mayank5885/Lab-Scale-Flume-Setup-for-Soil-Flow-Study/README.md

# Lab Scale Flume Setup for Soil Flow Study

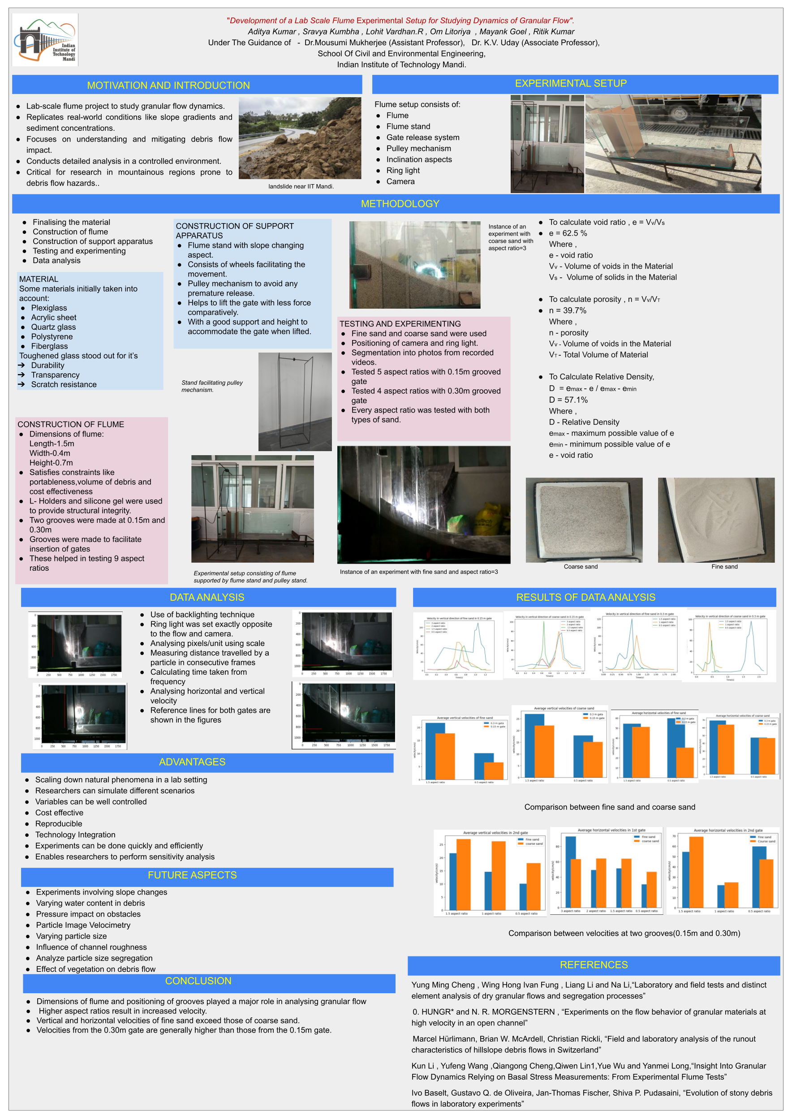
[picture p1: POSTER.png]
POSTER_final
