mayank5885/Lab-Scale-Flume-Setup-for-Soil-Flow-Study/POSTER_final.pdf

"Development of a Lab Scale Flume Experimental Setup for Studying Dynamics of Granular Flow". Aditya Kumar , Sravya Kumbha , Lohit Vardhan.R , Om Litoriya , Mayank Goel , Ritik Kumar Under The Guidance of - Dr.Mousumi Mukherjee (Assistant Professor), Dr. K.V. Uday (Associate Professor), School Of Civil and Environmental Engineering, Indian Institute of Technology Mandi.

### MOTIVATION AND INTRODUCTION

### METHODOLOGY

### RESULTS OF DATA ANALYSIS

### FUTURE ASPECTS

### ADVANTAGES

### CONCLUSION

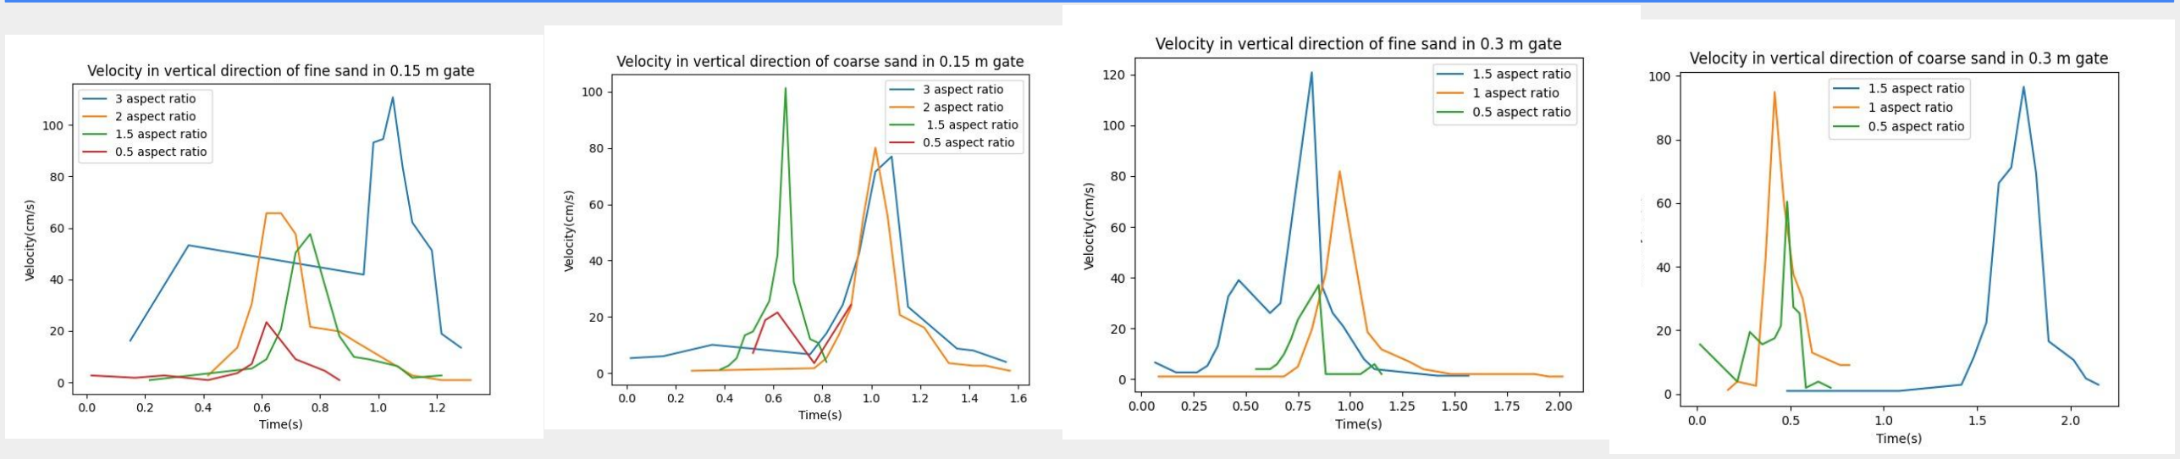
[picture p22: figure]

### REFERENCES

- Lab-scale flume project to study granular flow dynamics.
- Replicates real-world conditions like slope gradients and sediment concentrations.
- Focuses on understanding and mitigating debris flow impact.
- Conducts detailed analysis in a controlled environment.
- Critical for research in mountainous regions prone to debris flow hazards..
- Scaling down natural phenomena in a lab setting
- Researchers can simulate different scenarios
- Variables can be well controlled
- Cost effective
- Reproducible
- Technology Integration
- Experiments can be done quickly and efficiently
- Enables researchers to perform sensitivity analysis
- Experiments involving slope changes
- Varying water content in debris
- Pressure impact on obstacles
- Particle Image Velocimetry
- Varying particle size
- Influence of channel roughness
- Analyze particle size segregation
- Effect of vegetation on debris flow
- To calculate void ratio , e = Vv/Vs
- e = 62.5 %
Where ,
e - void ratio
Vv - Volume of voids in the Material Vs - Volume of solids in the Material
- To calculate porosity , n = Vv/VT
- n = 39.7%
Where ,
n - porosity
Vv - Volume of voids in the Material VT - Total Volume of Material
- To Calculate Relative Density,

D = emax - e / emax - emin
D = 57.1%
Where ,
D - Relative Density
emax - maximum possible value of e emin - minimum possible value of e e - void ratio

Yung Ming Cheng , Wing Hong Ivan Fung , Liang Li and Na Li,“Laboratory and field tests and distinct element analysis of dry granular flows and segregation processes”

0. HUNGR* and N. R. MORGENSTERN , “Experiments on the flow behavior of granular materials at high velocity in an open channel”

Marcel Hürlimann, Brian W. McArdell, Christian Rickli, “Field and laboratory analysis of the runout characteristics of hillslope debris flows in Switzerland”

Kun Li , Yufeng Wang ,Qiangong Cheng,Qiwen Lin1,Yue Wu and Yanmei Long,“Insight Into Granular Flow Dynamics Relying on Basal Stress Measurements: From Experimental Flume Tests”

Ivo Baselt, Gustavo Q. de Oliveira, Jan-Thomas Fischer, Shiva P. Pudasaini, “Evolution of stony debris flows in laboratory experiments”

- Finalising the material
- Construction of flume
- Construction of support apparatus
- Testing and experimenting
- Data analysis

CONSTRUCTION OF FLUME
- Dimensions of flume:
Length-1.5m
Width-0.4m
Height-0.7m
- Satisfies constraints like portableness,volume of debris and cost effectiveness
- L- Holders and silicone gel were used to provide structural integrity.
- Two grooves were made at 0.15m and 0.30m
- Grooves were made to facilitate insertion of gates
- These helped in testing 9 aspect ratios

Flume setup consists of:
- Flume
- Flume stand
- Gate release system
- Pulley mechanism
- Inclination aspects
- Ring light
- Camera

MATERIAL
Some materials initially taken into account:
- Plexiglass
- Acrylic sheet
- Quartz glass
- Polystyrene
- Fiberglass
Toughened glass stood out for it’s ➔ Durability
➔ Transparency
➔ Scratch resistance

### EXPERIMENTAL SETUP

CONSTRUCTION OF SUPPORT
APPARATUS
- Flume stand with slope changing aspect.
- Consists of wheels facilitating the movement.
- Pulley mechanism to avoid any premature release.
- Helps to lift the gate with less force comparatively.
- With a good support and height to accommodate the gate when lifted.

TESTING AND EXPERIMENTING
- Fine sand and coarse sand were used
- Positioning of camera and ring light.
- Segmentation into photos from recorded videos.
- Tested 5 aspect ratios with 0.15m grooved gate
- Tested 4 aspect ratios with 0.30m grooved gate
- Every aspect ratio was tested with both types of sand.

Stand facilitating pulley
mechanism.

Experimental setup consisting of flume supported by flume stand and pulley stand.

### DATA ANALYSIS

- Use of backlighting technique
- Ring light was set exactly opposite to the flow and camera.
- Analysing pixels/unit using scale
- Measuring distance travelled by a particle in consecutive frames
- Calculating time taken from frequency
- Analysing horizontal and vertical velocity
- Reference lines for both gates are shown in the figures
Coarse sand | Fine sand

landslide near IIT Mandi.

Instance of an experiment with fine sand and aspect ratio=3

Instance of an
experiment with
coarse sand with
aspect ratio=3

Comparison between fine sand and coarse sand

Comparison between velocities at two grooves(0.15m and 0.30m)

- Dimensions of flume and positioning of grooves played a major role in analysing granular flow
- Higher aspect ratios result in increased velocity.
- Vertical and horizontal velocities of fine sand exceed those of coarse sand.
- Velocities from the 0.30m gate are generally higher than those from the 0.15m gate.
