mayank5885/Lab-Scale-Flume-Setup-for-Soil-Flow-Study/cad files /dimet.JPG

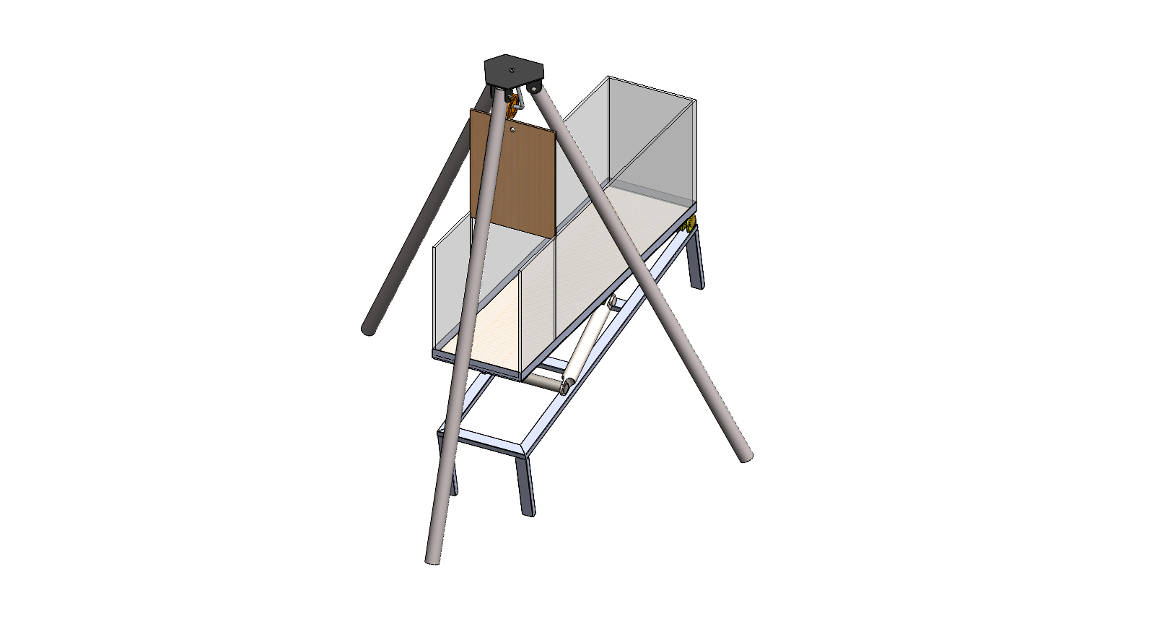
cad files /dimet.JPG
