mayank5885/Lab-Scale-Flume-Setup-for-Soil-Flow-Study/cad files /front.JPG

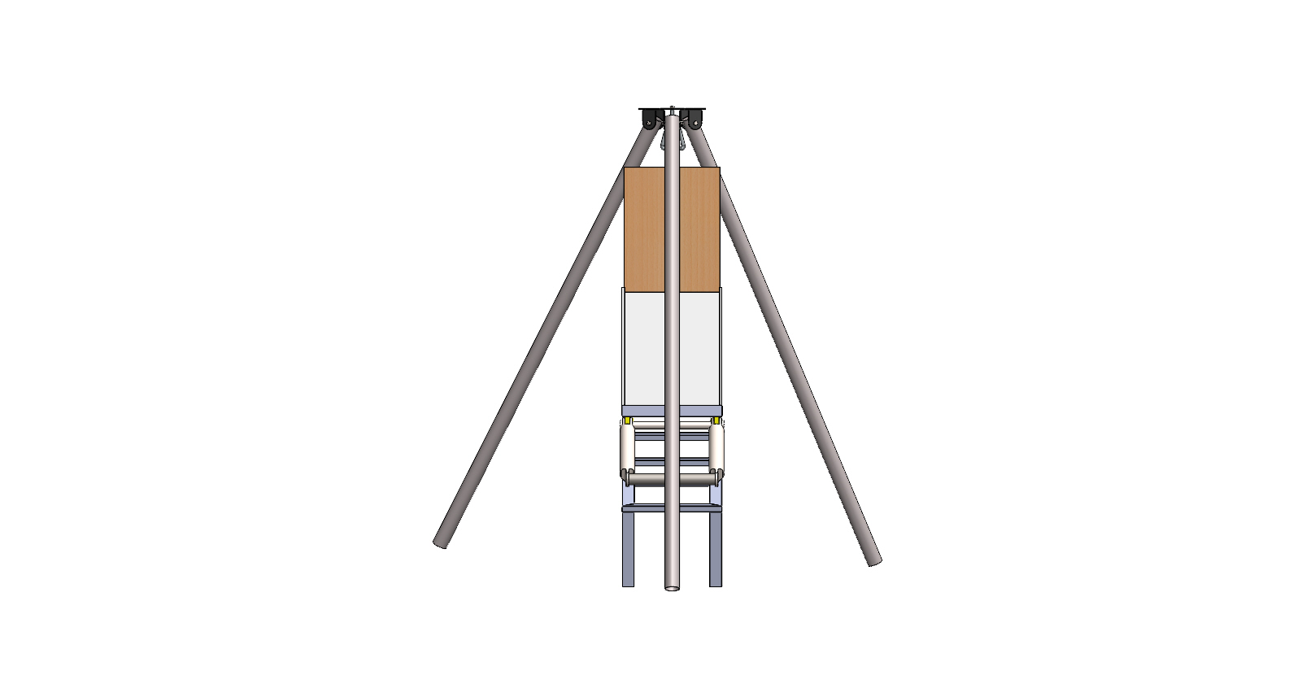
cad files /front.JPG
