mayank5885/Lab-Scale-Flume-Setup-for-Soil-Flow-Study/cad files /isometric.JPG

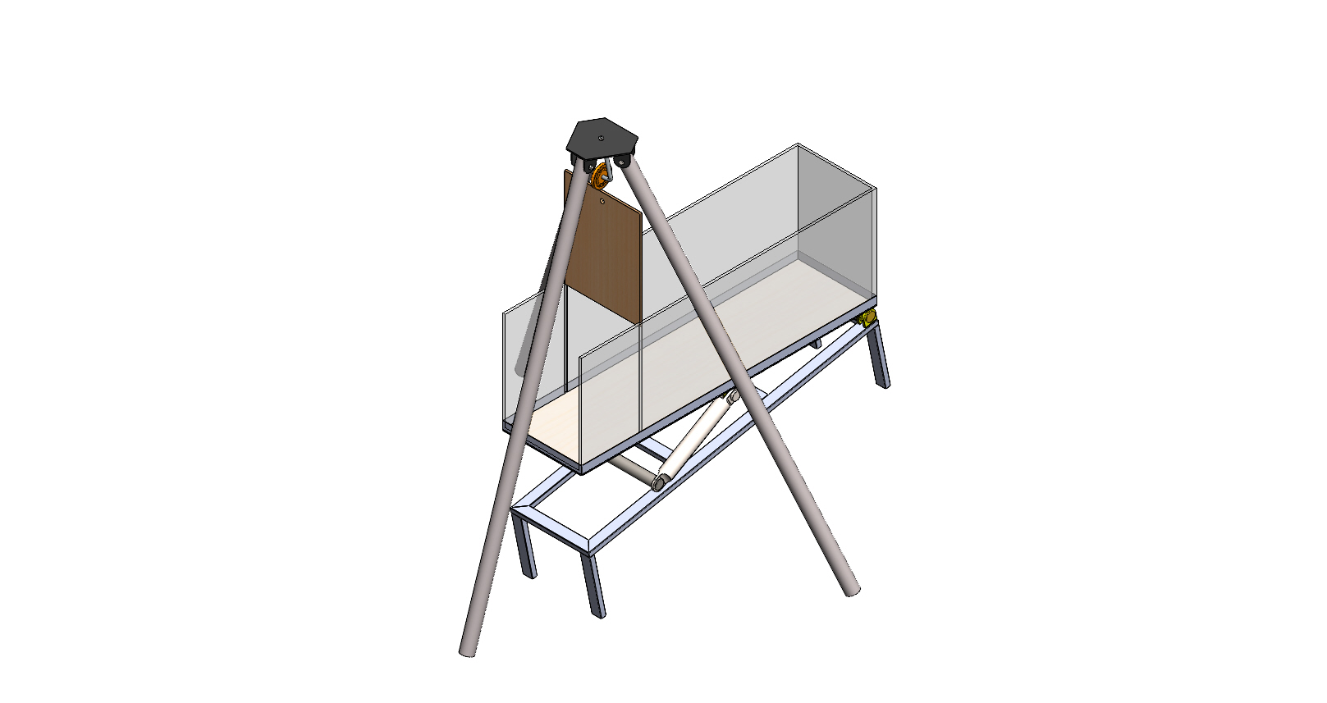
cad files /isometric.JPG
