mayank5885/Lab-Scale-Flume-Setup-for-Soil-Flow-Study/cad files /right.JPG

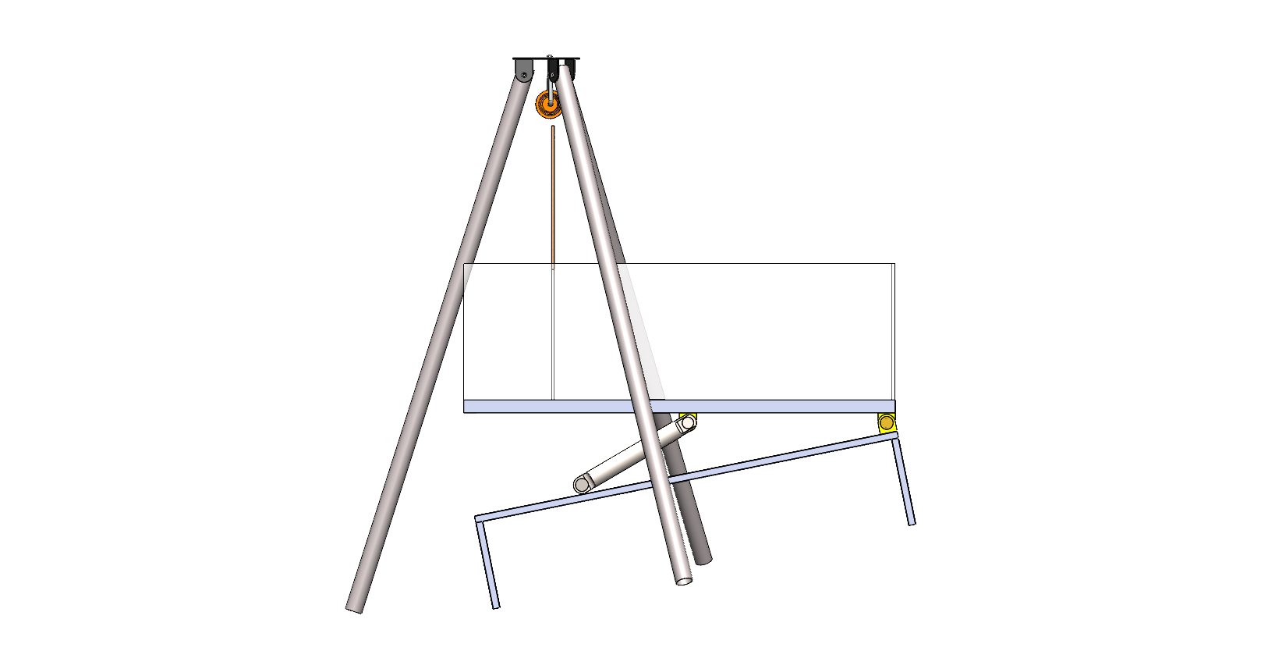
cad files /right.JPG
