mayank5885/Lab-Scale-Flume-Setup-for-Soil-Flow-Study/graph1.png

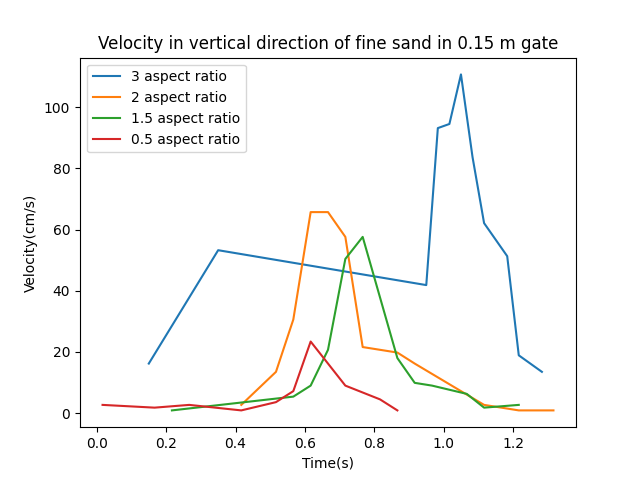
graph1.png
