mayank5885/Lab-Scale-Flume-Setup-for-Soil-Flow-Study/cad files /back.SLDASM

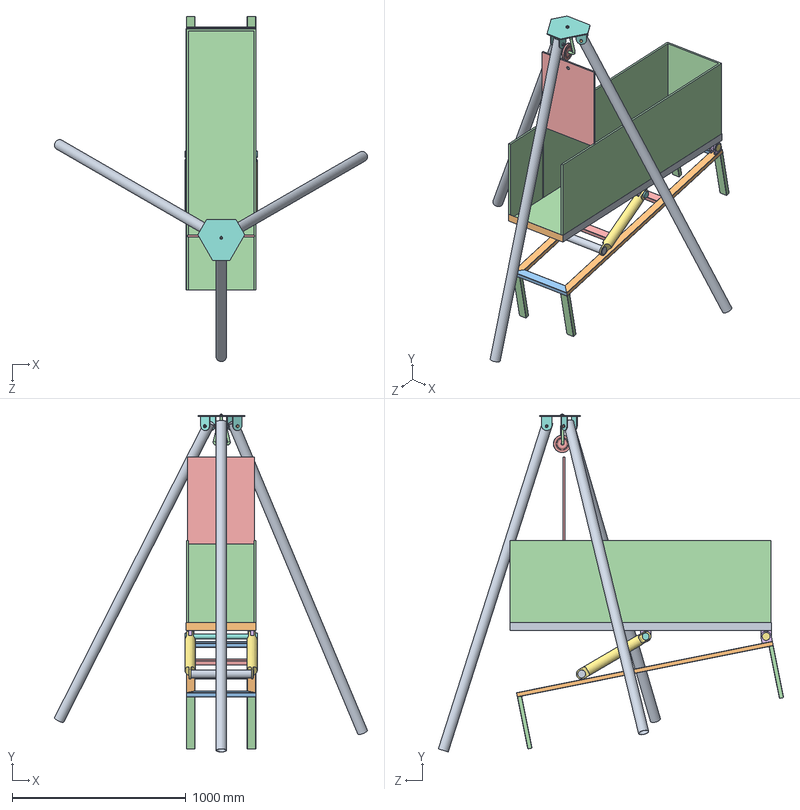
[picture p28: CAD file, 2024-07-07]
cad files /back.SLDASM
1799.6 x 1942.7 x 1985.0 mm
lbrack1500 x 2
lbrack400 x 2
baswood
glass
gate
hin x 4
supp x 2
uprod
dowsupp
recpro1500 x 2
recpro400 x 2
recpro1ft x 4
recpro100mm x 2
hing10 x 4
scre x 2
top
pipe x 3
hhs(grade c)_is x 3
hexagon nut style 1_is x 4
pullley holder
pulley
