mayank5885/Lab-Scale-Flume-Setup-for-Soil-Flow-Study/cad files /Flume Stand/pulley 3/Assem3.SLDASM

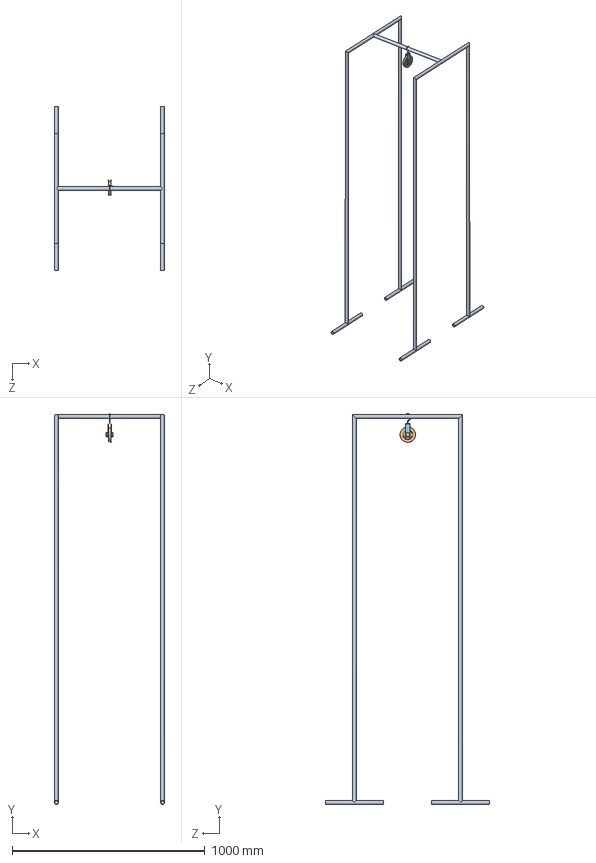
[picture p29: CAD file, 2024-07-07]
cad files /Flume Stand/pulley 3/Assem3.SLDASM
572.1 x 2026.0 x 850.8 mm
stand
pulley
holder
hex finished bolt_ai
heavy hex nut_ai
