mayank5885/Lab-Scale-Flume-Setup-for-Soil-Flow-Study/cad files /Flume Stand/flume Stand-Ritik.SLDASM

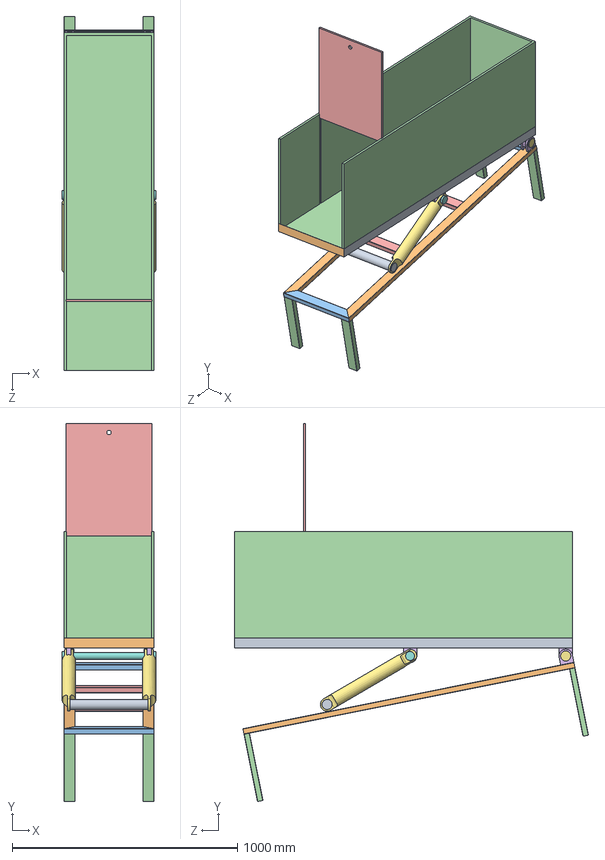
[picture p30: CAD file, 2024-07-07]
cad files /Flume Stand/flume Stand-Ritik.SLDASM
416.7 x 1679.5 x 1572.8 mm
lbrack1500 x 2
lbrack400 x 2
baswood
glass
gate
hin x 4
supp x 2
uprod
dowsupp
recpro1500 x 2
recpro400 x 2
recpro1ft x 4
recpro100mm x 2
hing10 x 4
scre x 2
