mayank5885/Lab-Scale-Flume-Setup-for-Soil-Flow-Study/cad files /Flume 2.SLDASM

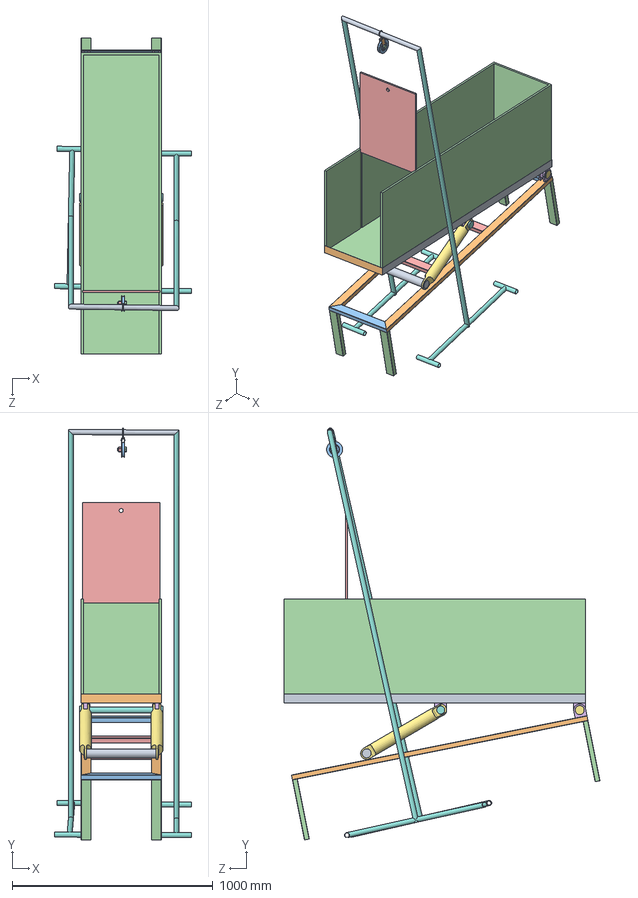
[picture p31: CAD file, 2024-07-07]
cad files /Flume 2.SLDASM
682.2 x 2050.1 x 1572.8 mm
lbrack1500 x 2
lbrack400 x 2
baswood
glass
gate
hin x 4
supp x 2
uprod
dowsupp
recpro1500 x 2
recpro400 x 2
recpro1ft x 4
recpro100mm x 2
hing10 x 4
scre x 2
std x 2
top
holder
pulley
hexagon fit bolt_is
heavy hex nut_ai
