mayank5885/Lab-Scale-Flume-Setup-for-Soil-Flow-Study/cad files /Flume Stand/pulley/Pulley Setup.SLDASM

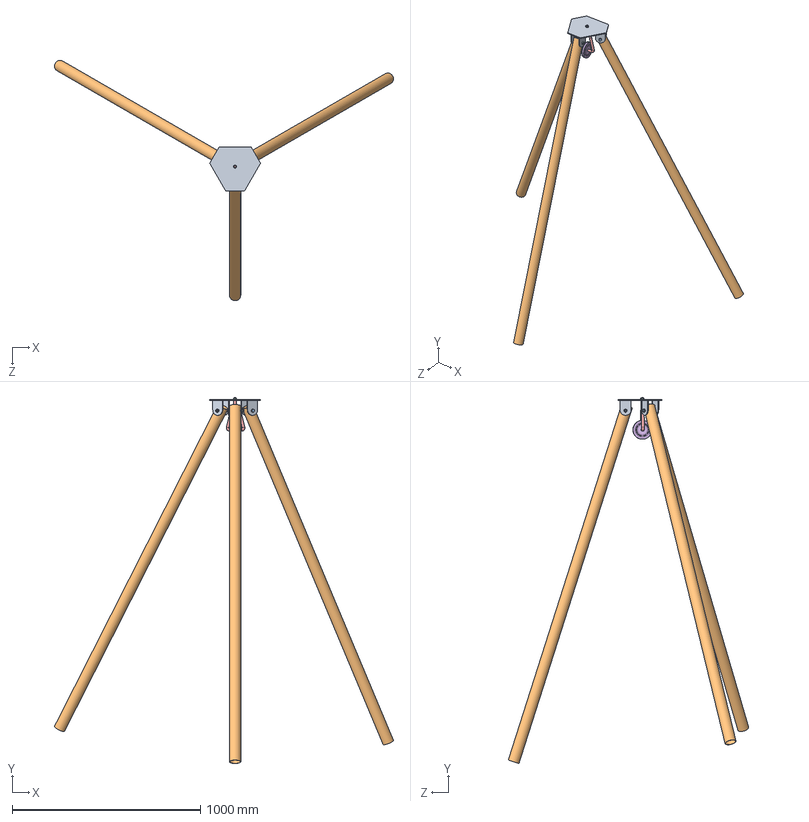
[picture p32: CAD file, 2024-07-07]
cad files /Flume Stand/pulley/Pulley Setup.SLDASM
1799.6 x 1942.7 x 1276.6 mm
top
pipe x 3
hhs(grade c)_is x 3
hexagon nut style 1_is x 4
pullley holder
pulley
