mayank5885/Lab-Scale-Flume-Setup-for-Soil-Flow-Study/cad files /Flume 3.SLDASM

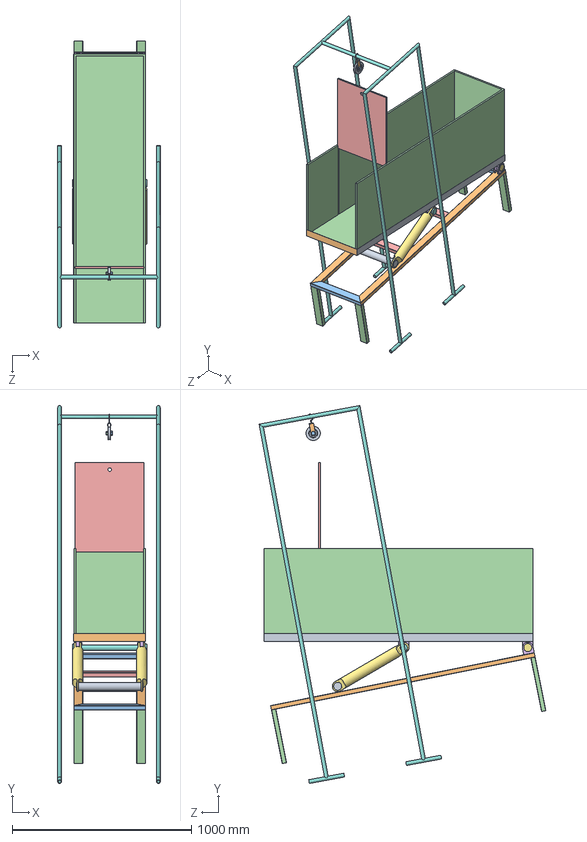
[picture p33: CAD file, 2024-07-07]
cad files /Flume 3.SLDASM
572.1 x 2108.0 x 1599.8 mm
lbrack1500 x 2
lbrack400 x 2
baswood
glass
gate
hin x 4
supp x 2
uprod
dowsupp
recpro1500 x 2
recpro400 x 2
recpro1ft x 4
recpro100mm x 2
hing10 x 4
scre x 2
stand
pulley
holder
hex finished bolt_ai
heavy hex nut_ai
