mayank5885/Lab-Scale-Flume-Setup-for-Soil-Flow-Study/cad files /Flume Stand/pulley 2/Assem6.SLDASM

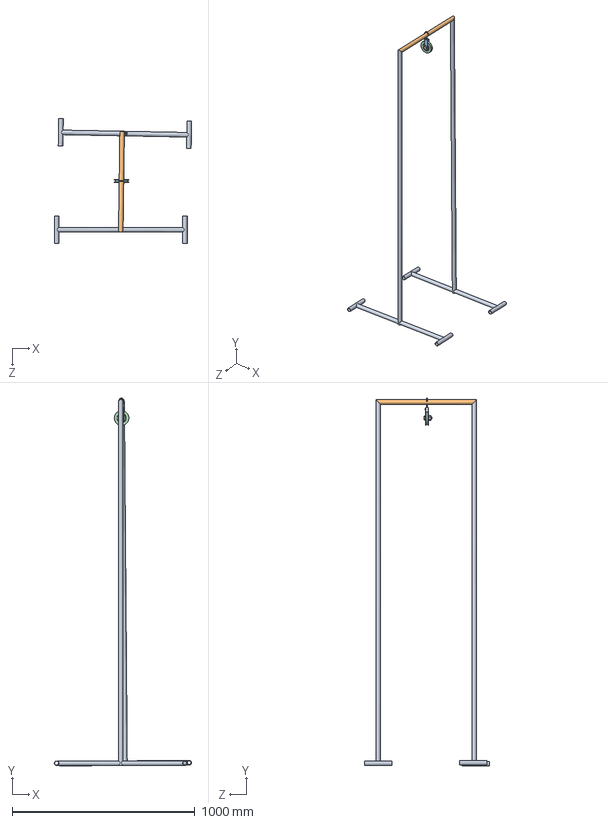
[picture p34: CAD file, 2024-07-07]
cad files /Flume Stand/pulley 2/Assem6.SLDASM
751.2 x 2011.7 x 682.2 mm
std x 2
top
holder
pulley
hexagon fit bolt_is
heavy hex nut_ai
