mayank5885/Lab-Scale-Flume-Setup-for-Soil-Flow-Study/cad files /Flume Stand/pulley 2/std.SLDPRT

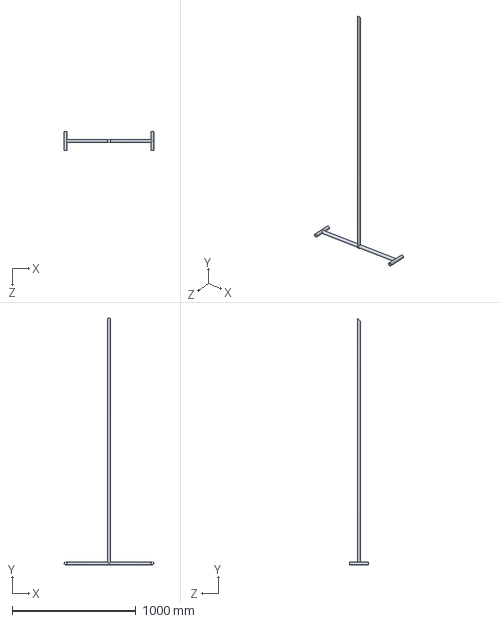
[picture p35: CAD file, 2024-07-07]
cad files /Flume Stand/pulley 2/std.SLDPRT
727.0 x 2000.0 x 150.0 mm
