mayank5885/Lab-Scale-Flume-Setup-for-Soil-Flow-Study/cad files /Flume Stand/pulley/pipe.SLDPRT

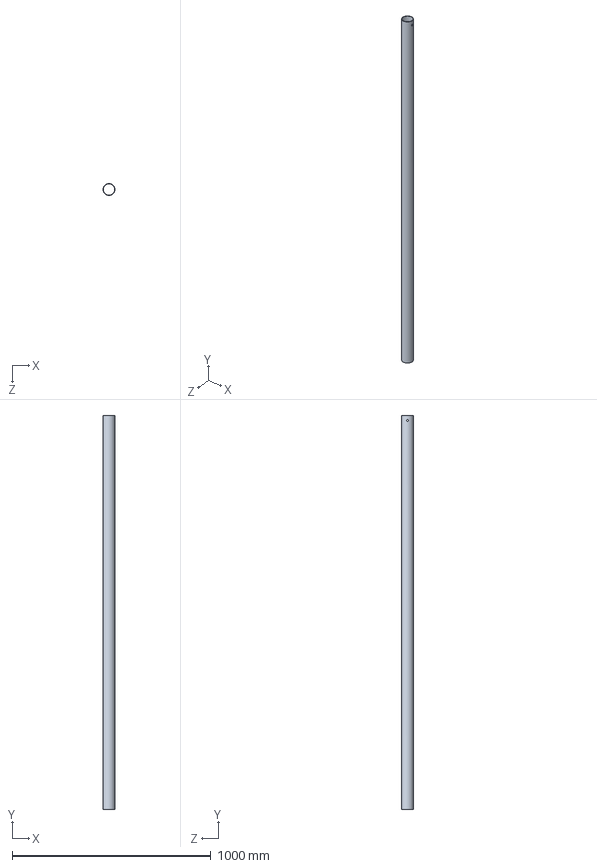
[picture p36: CAD file, 2024-07-07]
cad files /Flume Stand/pulley/pipe.SLDPRT
60.0 x 1981.0 x 60.0 mm
