mayank5885/Lab-Scale-Flume-Setup-for-Soil-Flow-Study/cad files /Flume Stand/recpro400.SLDPRT

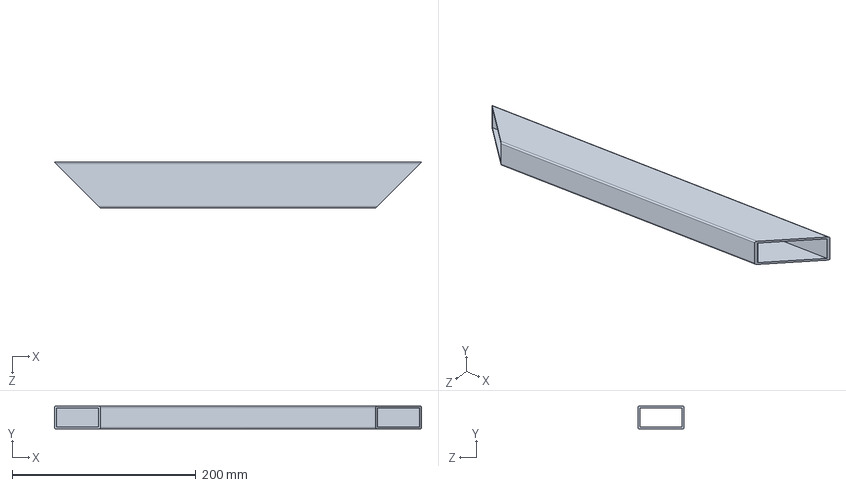
[picture p37: CAD file, 2024-07-07]
cad files /Flume Stand/recpro400.SLDPRT
400.0 x 25.0 x 50.0 mm
