mayank5885/Lab-Scale-Flume-Setup-for-Soil-Flow-Study/cad files /Flume Stand/pulley 2/pulley.SLDPRT

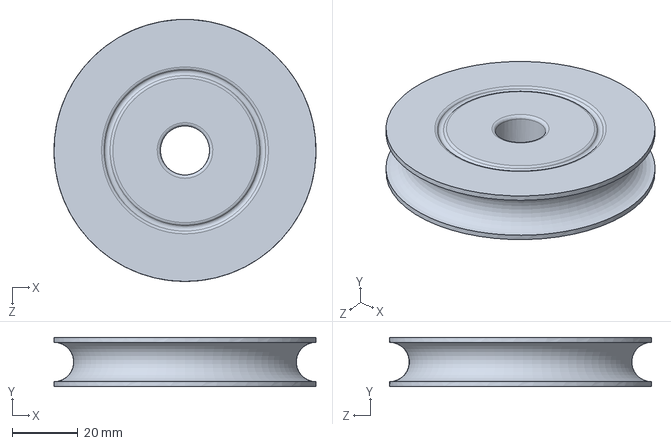
[picture p38: CAD file, 2024-07-07]
cad files /Flume Stand/pulley 2/pulley.SLDPRT
80.0 x 15.0 x 80.0 mm
