mayank5885/Lab-Scale-Flume-Setup-for-Soil-Flow-Study/cad files /Flume Stand/pulley 3/stand.SLDPRT

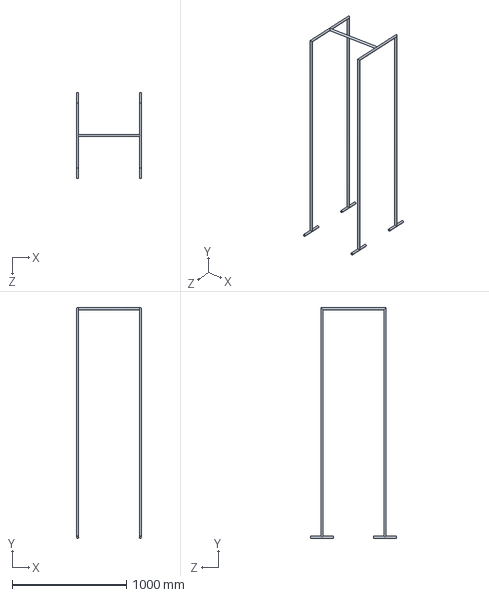
[picture p39: CAD file, 2024-07-07]
cad files /Flume Stand/pulley 3/stand.SLDPRT
572.1 x 2021.3 x 750.8 mm
