mayank5885/Lab-Scale-Flume-Setup-for-Soil-Flow-Study/cad files /Flume Stand/pulley/top.SLDPRT

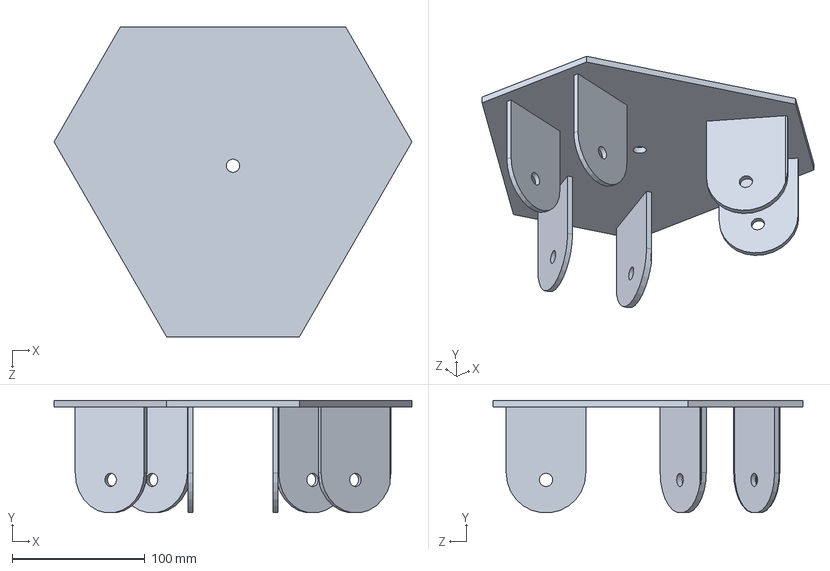
[picture p40: CAD file, 2024-07-07]
cad files /Flume Stand/pulley/top.SLDPRT
270.0 x 84.8 x 233.8 mm
