mayank5885/Lab-Scale-Flume-Setup-for-Soil-Flow-Study/cad files /Flume Stand/recpro1ft.SLDPRT

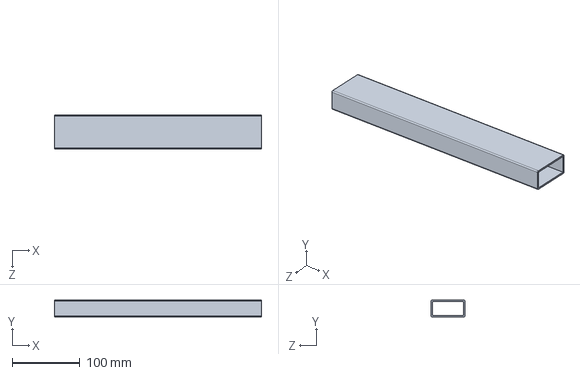
[picture p41: CAD file, 2024-07-07]
cad files /Flume Stand/recpro1ft.SLDPRT
304.8 x 25.0 x 50.0 mm
