mayank5885/Lab-Scale-Flume-Setup-for-Soil-Flow-Study/cad files /Flume Stand/pulley 2/top.SLDPRT

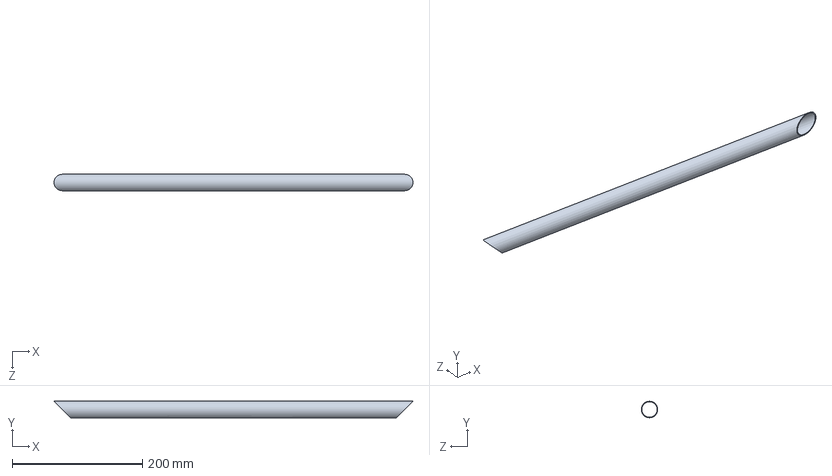
[picture p42: CAD file, 2024-07-07]
cad files /Flume Stand/pulley 2/top.SLDPRT
550.8 x 25.4 x 25.4 mm
