mayank5885/Lab-Scale-Flume-Setup-for-Soil-Flow-Study/cad files /Flume Stand/pulley/pulley.SLDPRT

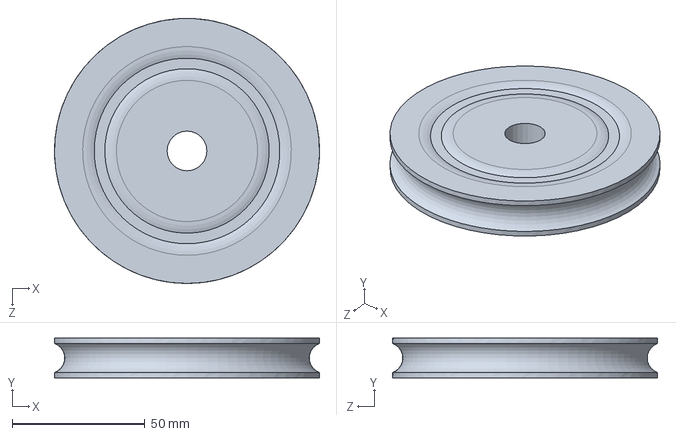
[picture p43: CAD file, 2024-07-07]
cad files /Flume Stand/pulley/pulley.SLDPRT
100.0 x 15.0 x 100.0 mm
