mayank5885/Lab-Scale-Flume-Setup-for-Soil-Flow-Study/cad files /Flume Stand/pulley 2/holder.SLDPRT

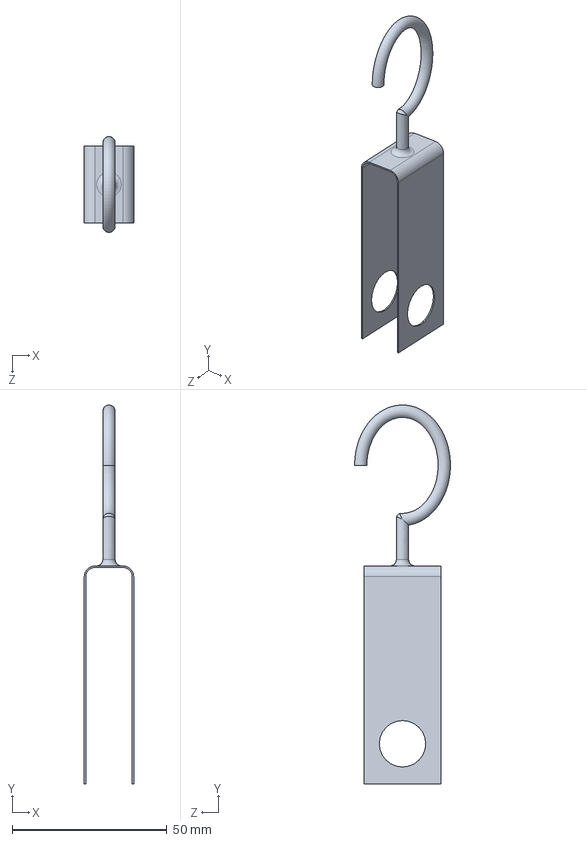
[picture p44: CAD file, 2024-07-07]
cad files /Flume Stand/pulley 2/holder.SLDPRT
16.0 x 122.5 x 31.0 mm
