mayank5885/Lab-Scale-Flume-Setup-for-Soil-Flow-Study/cad files /Flume Stand/supp.SLDPRT

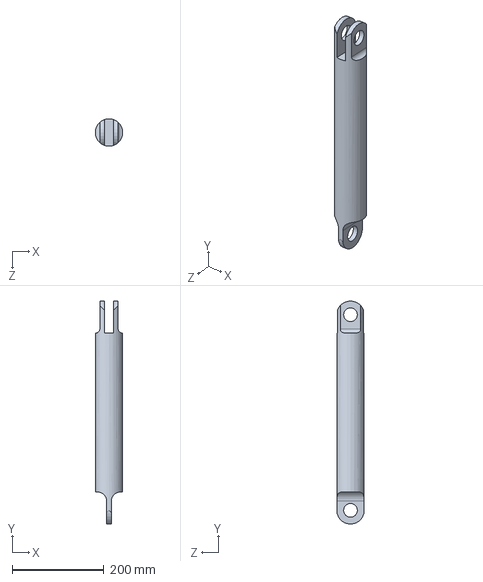
[picture p45: CAD file, 2024-07-07]
cad files /Flume Stand/supp.SLDPRT
60.0 x 486.8 x 60.0 mm
