mayank5885/Lab-Scale-Flume-Setup-for-Soil-Flow-Study/cad files /Flume Stand/hin.SLDPRT

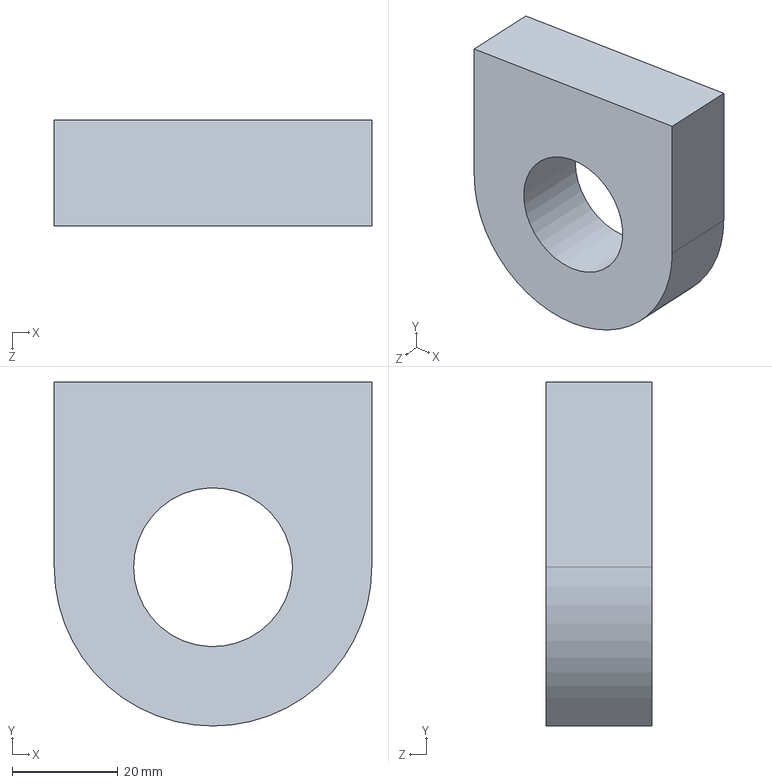
[picture p46: CAD file, 2024-07-07]
cad files /Flume Stand/hin.SLDPRT
60.0 x 65.0 x 20.0 mm
