mayank5885/Lab-Scale-Flume-Setup-for-Soil-Flow-Study/cad files /Flume Stand/pulley/pullley holder.SLDPRT

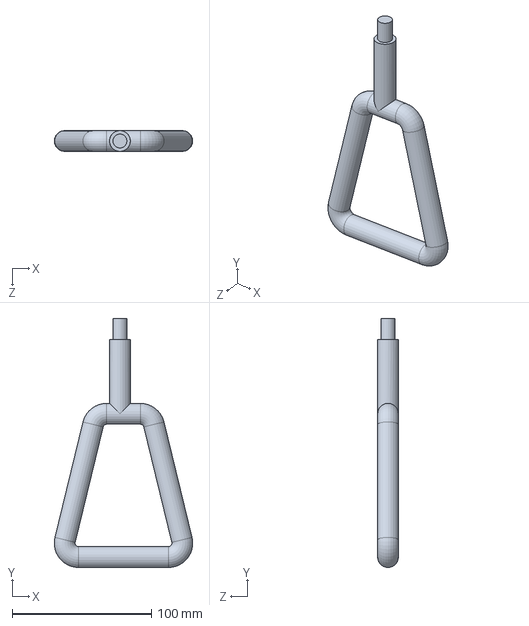
[picture p47: CAD file, 2024-07-07]
cad files /Flume Stand/pulley/pullley holder.SLDPRT
99.5 x 179.0 x 15.0 mm
