mayank5885/Lab-Scale-Flume-Setup-for-Soil-Flow-Study/cad files /Flume Stand/scre.SLDPRT

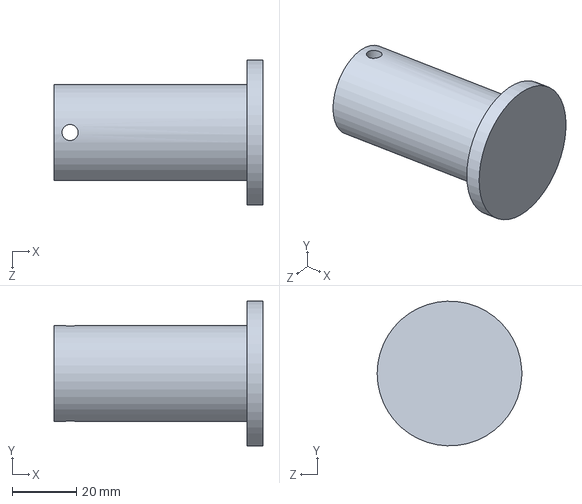
[picture p48: CAD file, 2024-07-07]
cad files /Flume Stand/scre.SLDPRT
65.0 x 45.0 x 45.0 mm
