mayank5885/Lab-Scale-Flume-Setup-for-Soil-Flow-Study/cad files /Flume Stand/recpro1500.SLDPRT

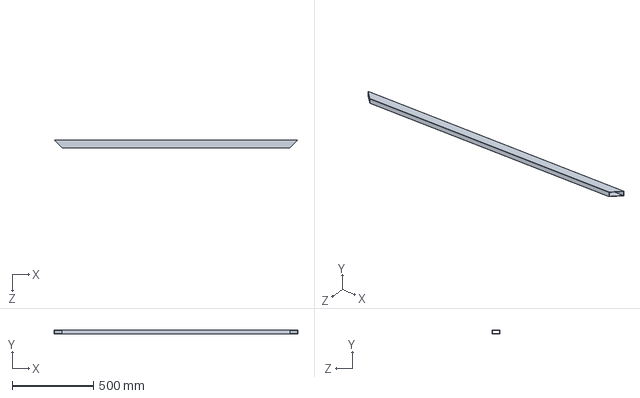
[picture p49: CAD file, 2024-07-07]
cad files /Flume Stand/recpro1500.SLDPRT
1500.0 x 25.0 x 50.0 mm
