mayank5885/Lab-Scale-Flume-Setup-for-Soil-Flow-Study/cad files /Flume Stand/recpro100mm.SLDPRT

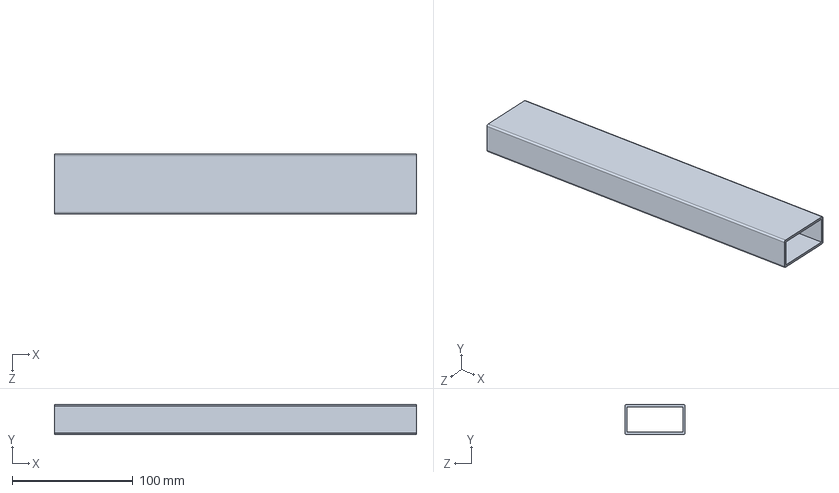
[picture p50: CAD file, 2024-07-07]
cad files /Flume Stand/recpro100mm.SLDPRT
300.0 x 25.0 x 50.0 mm
