mayank5885/Lab-Scale-Flume-Setup-for-Soil-Flow-Study/cad files /Flume Stand/hing10.SLDPRT

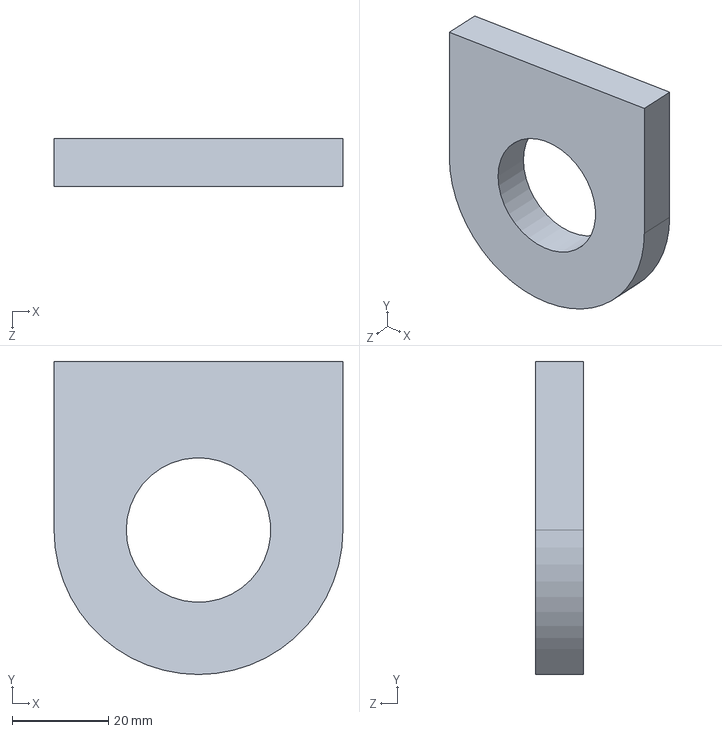
[picture p51: CAD file, 2024-07-07]
cad files /Flume Stand/hing10.SLDPRT
60.0 x 65.0 x 10.0 mm
