mayank5885/Lab-Scale-Flume-Setup-for-Soil-Flow-Study/cad files /Flume Stand/lbrack1500.SLDPRT

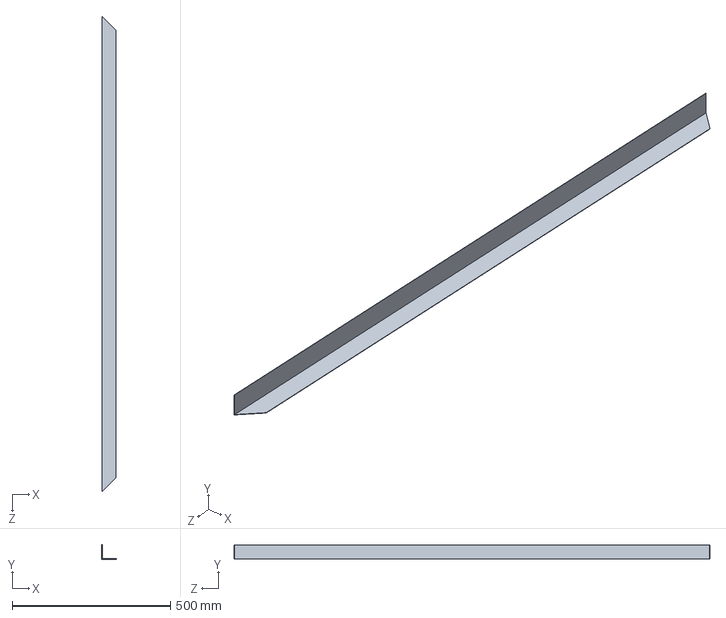
[picture p52: CAD file, 2024-07-07]
cad files /Flume Stand/lbrack1500.SLDPRT
45.0 x 45.0 x 1501.7 mm
