mayank5885/Lab-Scale-Flume-Setup-for-Soil-Flow-Study/cad files /Flume Stand/baswood.SLDPRT

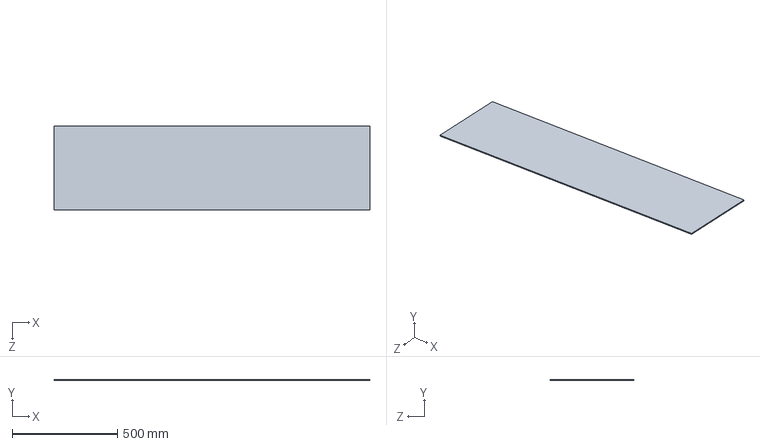
[picture p53: CAD file, 2024-07-07]
cad files /Flume Stand/baswood.SLDPRT
1500.0 x 5.00 x 400.0 mm
