mayank5885/Lab-Scale-Flume-Setup-for-Soil-Flow-Study/cad files /Flume Stand/lbrack400.SLDPRT

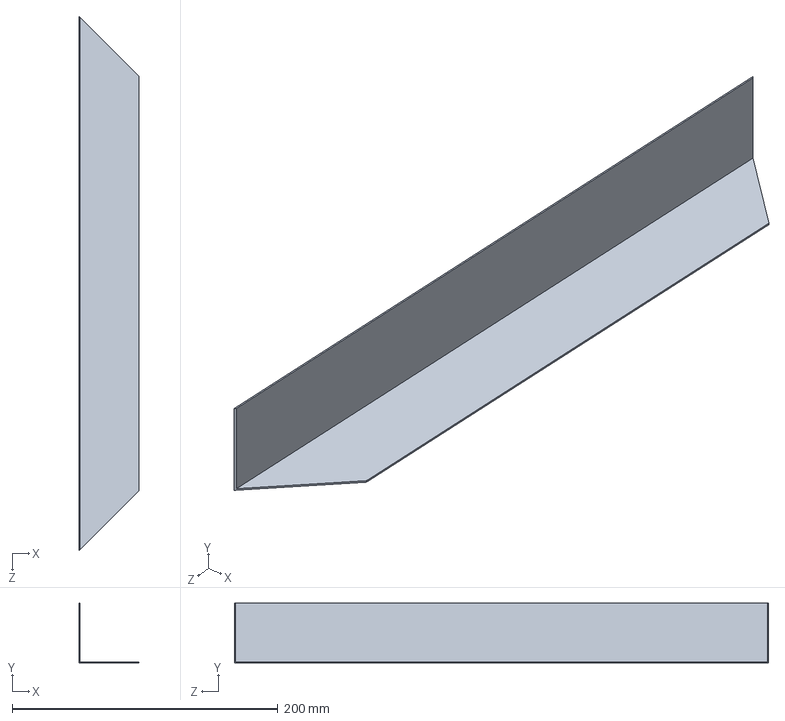
[picture p54: CAD file, 2024-07-07]
cad files /Flume Stand/lbrack400.SLDPRT
45.0 x 45.0 x 401.7 mm
