mayank5885/Lab-Scale-Flume-Setup-for-Soil-Flow-Study/cad files /Flume Stand/glass.SLDPRT

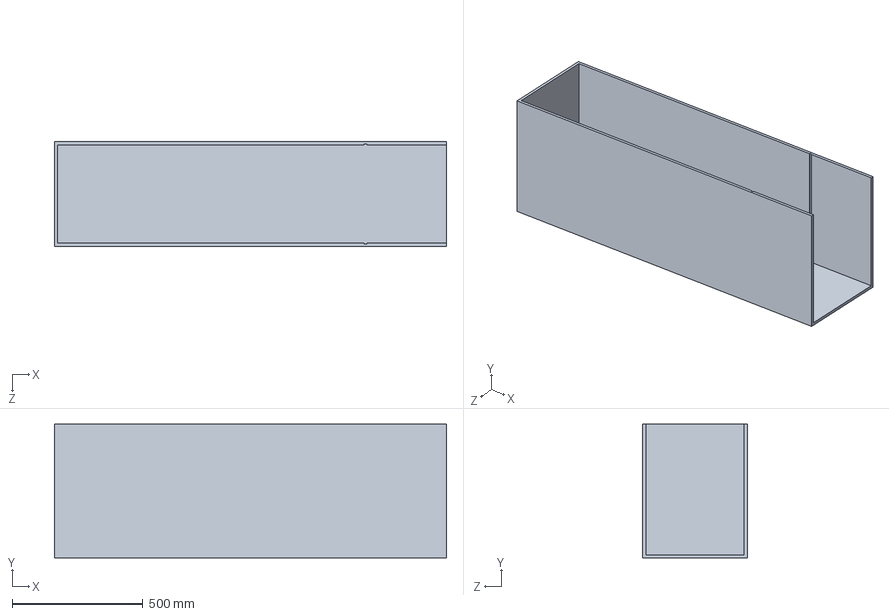
[picture p55: CAD file, 2024-07-07]
cad files /Flume Stand/glass.SLDPRT
1500.0 x 512.0 x 400.0 mm
