mayank5885/Lab-Scale-Flume-Setup-for-Soil-Flow-Study/cad files /Flume Stand/dowsupp.SLDPRT

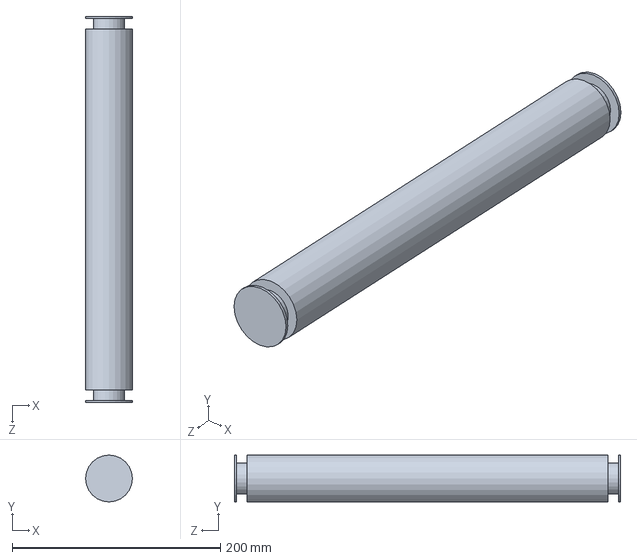
[picture p56: CAD file, 2024-07-07]
cad files /Flume Stand/dowsupp.SLDPRT
45.0 x 45.0 x 370.7 mm
