mayank5885/Lab-Scale-Flume-Setup-for-Soil-Flow-Study/cad files /Flume Stand/uprod.SLDPRT

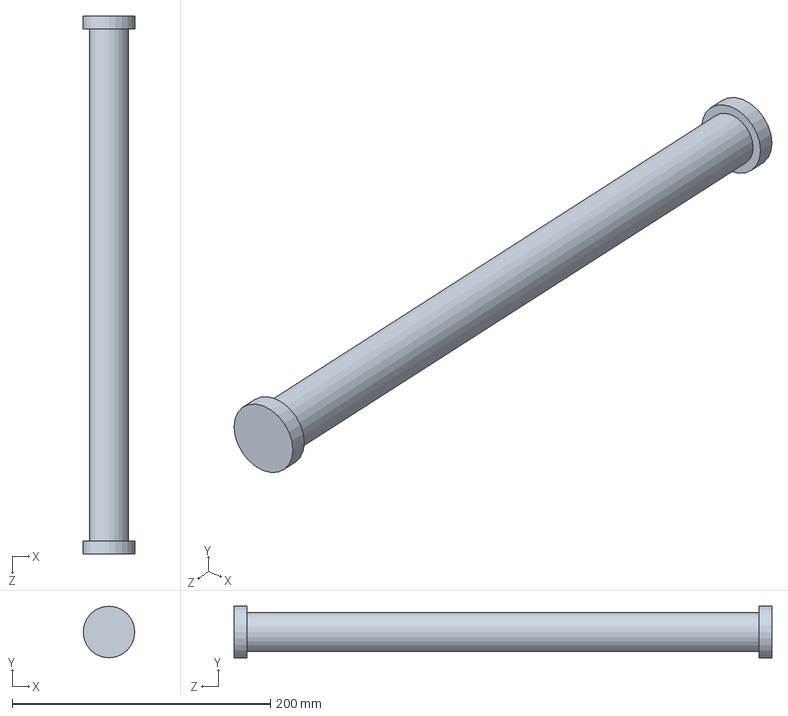
[picture p57: CAD file, 2024-07-07]
cad files /Flume Stand/uprod.SLDPRT
40.0 x 40.0 x 416.7 mm
