mayank5885/Lab-Scale-Flume-Setup-for-Soil-Flow-Study/cad files /Flume Stand/hing2.SLDPRT

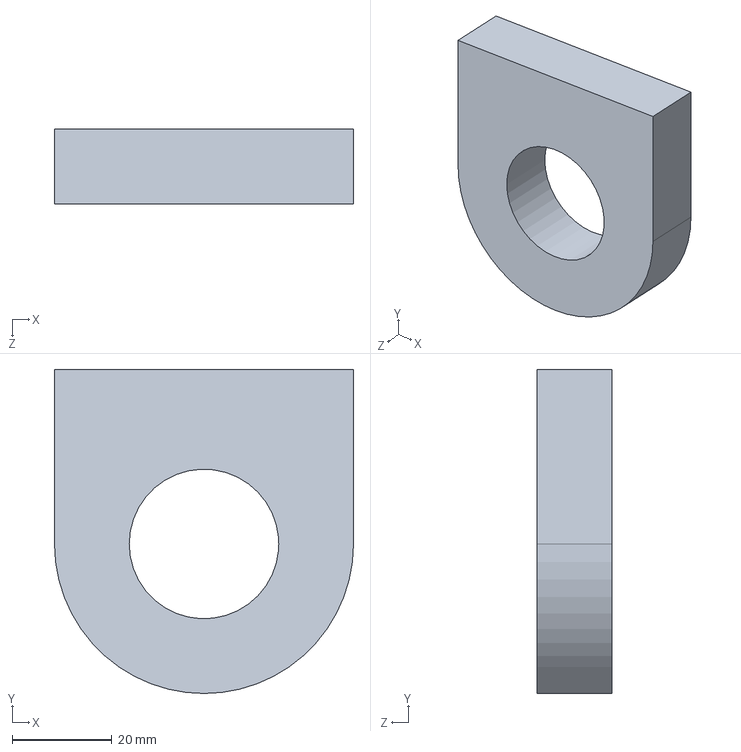
[picture p58: CAD file, 2024-07-07]
cad files /Flume Stand/hing2.SLDPRT
60.0 x 65.0 x 15.0 mm
