mayank5885/Lab-Scale-Flume-Setup-for-Soil-Flow-Study/cad files /Flume Stand/gate.SLDPRT

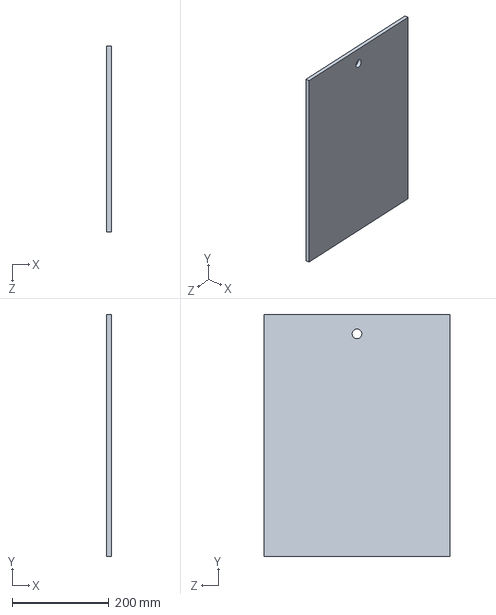
[picture p59: CAD file, 2024-07-07]
cad files /Flume Stand/gate.SLDPRT
10.0 x 500.0 x 384.0 mm
