mayank5885/Lab-Scale-Flume-Setup-for-Soil-Flow-Study/(list of files, cad)

Other CAD files:
cad files /left.SLDASM
cad files /Flume Stand/flume Stand.SLDASM
cad files /Flume Setup.STEP
cad files /Flume Setup.SLDASM
